avgustint/tower-clock-oled/(commit log)

2024-03-28 Update wiring diagram
2024-03-28 Update wiring
2024-11-10 Added daily reset and optimizing
    [tower-clock-oled.ino]
2024-11-12 removed the temperature info and leave the screen on
2025-03-31 Fixed daylight savings bug
    [tower-clock-oled.ino]
